CamSoper/Inferno/Hardware/Images/Telemetry.png

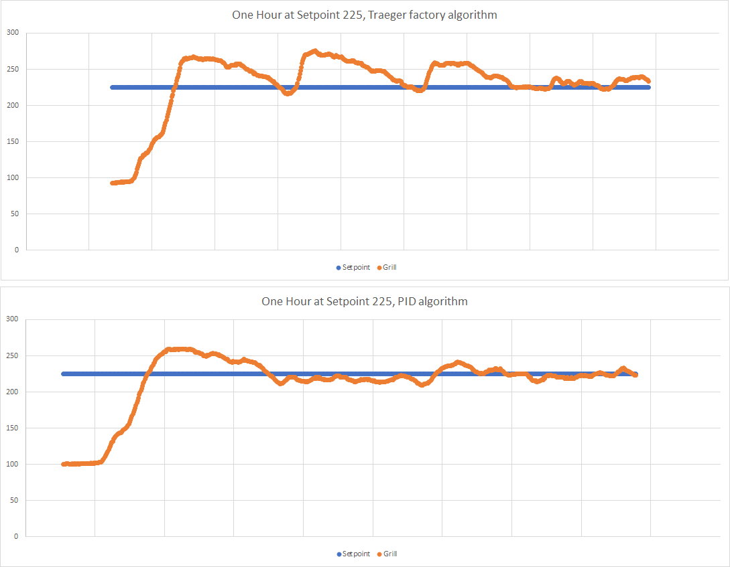
Hardware/Images/Telemetry.png
