CamSoper/Inferno/Hardware/Bezel/Bezel.stl

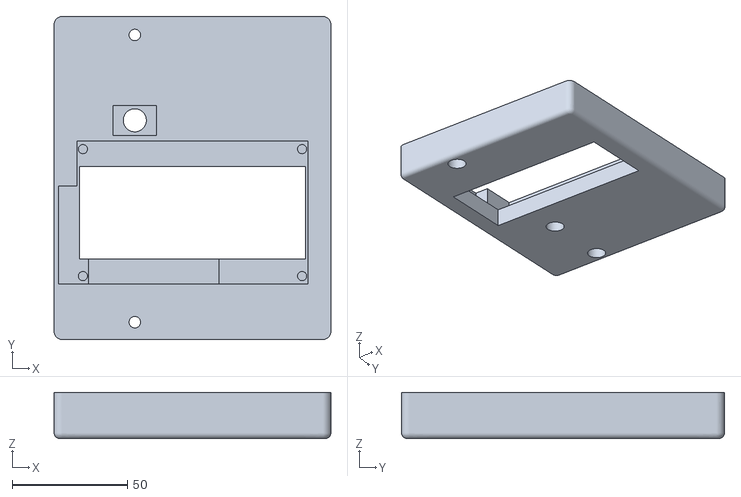
[picture p3: CAD file, 2019-07-02]
Hardware/Bezel/Bezel.stl
120.0 x 140.0 x 20.0
