CamSoper/Inferno/(list of files, drawings)

Other design files:
Hardware/Fritzing/Inferno.fzz
