CamSoper/Inferno/(threads)

Thread 9 (2025-03-19):

Shutdown doesn't cancel fire health alert

CamSoper, 2025-03-19:
Was running with the door open to test fire health alert, switched to shutdown and fire health alert never reset
