CamSoper/Inferno/(commit log)

2019-06-29 Moved igniter to its own thread
2019-06-30 More testing results
    [Inferno.fzz]
2019-06-30 updated fritzing diagram
    [Inferno.fzz]
2019-07-02 PID improvements
2019-07-02 Adding bezel design
    [Bezel.stl]
2019-07-12 Refactored relay-based devices
2019-07-12 A little more relay refactoring
2019-07-17 Updated image, AddSingleton
    [Inferno.fzz]
2022-11-24 Using built-in Clamp now
2022-12-07 Better fireminder, using built-in clamp()
2026-03-07 Reduce auger feed during reignition to prevent pellet accumulation
    When FireMinder detects the fire is out and activates the igniter for
    reignition, the Smoker now switches to a minimal feed pattern (3s on,
    57s off) instead of the normal cooking feed rate. This prevents
    unburned pellets from flooding the firepot, which could cause a
    dangerous temperature spike when they finally ignite.
    https://claude.ai/code/session_016pJd48GAzYXL4BTXptpHxs
2026-03-07 Reject out-of-range sensor readings to prevent HA graph spikes
    When an RTD sensor glitches (loose wire, SPI noise, etc.), the raw
    ADC value can produce wildly invalid temperatures (e.g., ADC=0
    yields Infinity via division by zero). These bad values get averaged
    into the 100-sample resistance buffer and flow straight through to
    MQTT/Home Assistant, causing massive graph spikes.
    Fix: validate each reading against a physically reasonable range
    (-20F to 1000F) before enqueuing. Bad readings are silently dropped,
    preserving the buffer of good values. If ALL readings are bad
    (sustained sensor failure), the queue empties and returns NaN, which
    Smoker.Temps already converts to -1 ("Unplugged" on di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
2026-03-07 Replace Newtonsoft.Json with System.Text.Json
    Newtonsoft.Json was only used in SmokerProxy for deserializing the
    status API response. Switch to System.Text.Json which is built into
    .NET and already used by ASP.NET on the API side. Uses
    PropertyNameCaseInsensitive to match ASP.NET's default camelCase
    output. Removes the Newtonsoft.Json package reference.
    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
2026-03-07 Add unit tests and GitHub Actions CI
    Create Inferno.Tests xUnit project with 32 tests covering:
    - RtdArray: ADC-to-resistance conversion, resistance-to-temp math,
    boundary values (ADC=0 → Infinity, ADC=1023)
    - Extensions: Clamp (double/int), IsCookingMode for all SmokerModes
    - SmokerPid: control variable direction (below/above setpoint),
    NaN guard, setpoint updates
    - FireMinder: GetFireCheckTemp for Smoke vs Hold modes, initial
    state, ResetFireStatus
    Add GitHub Actions workflow (ci.yml) that runs build + test on push
    to main and on PRs.
    Also make RtdArray's static math methods internal (were private) and
    add InternalsVisibleTo so the test project can access them.
    https://claude.ai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
2026-03-07 Add Pulumi C# project for SSH deployment to Raspberry Pi
    Replaces the Windows batch files with a cross-platform Pulumi
    deployment that:
    1. Publishes all three .NET projects locally (parallel)
    2. Stops running services on the Pi via SSH
    3. Copies published artifacts to the Pi via SCP
    4. Installs/starts systemd services and enables them on boot
    Uses Pulumi.Command provider for remote SSH commands and
    CopyToRemote for file transfer. Configurable via Pulumi config
    for host, user, remote path, and SSH key path.
    Usage:
    cd Inferno.Deploy
    pulumi up
    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
2026-03-07 Fix PID division by zero, shadowed CTS field, remove batch files, clean up TODOs
    - SmokerPid: change dT.Seconds (int, truncated) to dT.TotalSeconds
    (double). The old code divided by zero whenever the control loop
    ran faster than 1Hz, producing NaN/Infinity in the derivative term.
    - Smoker constructor: remove accidental type declaration that
    shadowed the _cts field with a local variable, leaving the field
    null until ModeLoop initialized it. A SetMode call during that
    window would NullRef.
    - Delete all publish.bat files (replaced by Pulumi deploy project).
    - Remove Visual Studio IDisposable template noise (commented-out
    finalizers, "TODO: free unmanaged resources", "Do not chang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
2026-03-24 Fix Fire Healthy state payload values and update device class in SmokerBridge
2026-04-28 Track Pulumi.main.yaml; rename ESC env to inferno-deploy/main
    Pulumi.<stack>.yaml was gitignored, but it's the only place the ESC env
    binding lives -- and Pulumi Cloud-side deployment settings have no env
    binding of their own. Without the file in version control, the deploy
    agent would either run with whatever local copy it happens to have or
    no binding at all. Tracking it now so the binding ships with commits.
    Env reference also flips inferno/mqtt -> inferno-deploy/main, aligning
    with the stack path (every <project>/main stack pairs with a
    <project>/main env).
2026-06-15 Staged fire recovery to stop starving recoverable fires
    The fire-health path collapsed the auger to ~5% duty (3s on / 57s off) the
    moment a fire looked unhealthy, which is below the rate that keeps a fire lit.
    A fire that had only dipped got starved out and became unrecoverable.
    Replace the binary healthy/starve behavior with floor-anchored staged recovery:
    - Fire-sustaining floor: no recovery path ever feeds below ~17% (the PID _uMin
    rationale). MaintenanceFeed (lid) and RecoveryFeed (~75%) both sit above it.
    - Lid-open detection (new LidMonitor): a catastrophic temp drop is cold air, not
    a dying fire. Ride it out on the maintenance floor with the PID frozen instead
    of triggering re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
2026-06-15 Restore unplugged-probe detection after sustained bad readings
    Rejecting out-of-range readings (to filter HA graph spikes) meant an unplugged
    probe's open-circuit readings were dropped and never enqueued. Since the queue
    only drains while enqueuing, it held its last good samples forever, so the probe
    kept reporting a stale temperature and never read as NaN/-1/"Unplugged".
    Track consecutive invalid readings per sensor; a brief burst is still filtered
    as noise, but a sustained run (~2s) drains the queue so the temperature reads
    NaN and surfaces as "Unplugged" again.
2026-06-15 Keep slow cold-start fires alive until ignition
    A fire warming from a cold start was killed by the fixed 10-minute igniter
    timeout before the grill could cross the 150F ignition threshold. The recovery
    path already resets its give-up clock on upward progress; apply the same logic
    to initial ignition so a slow-but-steady climb survives while a genuinely dead
    light (no temperature rise) still times out to Error.
2026-06-15 Harden cook stability: graceful shutdown, preheat race, PID guards (#20)
    Address the highest-value stability/safety findings from the project review:
    - Graceful shutdown (C1): Smoker is now IDisposable and the host's
    ApplicationStopping hook tears it down, so a clean stop/SIGTERM drives the
    auger and igniter to a safe off-state and releases GPIO/SPI/I2C instead of
    leaving relays in their last commanded state. All background loops (mode,
    fire minder, display, ADC read, preheat) now stop on a lifetime token.
    - Preheat sampling (C2/N1): moved PreheatMonitor.Update out of the Status
    property getter into a dedicated 1 Hz loop, and guarded the monitor's
    non-concurrent queue with a lo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
2026-06-15 Serialize Pulumi publish steps to avoid Inferno.Common build races (#21)
    The deploy created publish-api, publish-mqtt, and publish-cli with no
    dependency between them, so Pulumi ran the three `dotnet publish` commands in
    parallel. Every service references Inferno.Common, so the parallel publishes
    rebuilt Common concurrently and collided on its obj/bin outputs (MSBuild file
    locks), failing the deploy.
    Chain each publish command to the previous one via DependsOn so only one
    `dotnet publish` touches the shared Inferno.Common build outputs at a time.
    Ordering only; no functional change.
2026-06-20 Make Sear full-feed gate relative to ignition temp (#23)
    Sear now switches from the gentle establishing feed to full auger at a margin
    above where the fire caught (InitialIgnitionTemp + 25F, tunable) instead of an
    absolute 180F, so cold/windy starts no longer stall in the 150-180F band.
    FireMinder exposes InitialIgnitionTemp, anchored to the initial catch and
    unaffected by recovery relights.
    Claude-Session: https://claude.ai/code/session_01APzBbDz9nDWgpiCi1A48vw
2026-07-05 Harden safety paths: sensor fail-safe, monotonic time, structured logging (#24)
    * Harden safety paths: sensor fail-safe, monotonic time, structured logging
    Address several code-review findings, focused on the fire-control paths.
    Safety fixes:
    - Sear mode now turns the blower on before feeding the auger. Previously a
    Sear entered from a cold blower (e.g. straight after Ready with a warm
    firepot) could feed pellets with no combustion air.
    - FireMinder fails safe to Error on a sustained invalid grill reading during
    a cook, instead of interpreting the -1 "unplugged" sentinel as a dying fire
    and running the aggressive recovery feed blind.
    - Display disposes the LCD and driver before the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
2026-10-27 Re-seed the PID after lid-open and other Hold pauses (#25)
    Hold skips the PID while the lid is open, but the PID's last timestamp
    stayed put, so the first update after the lid closed computed dt over
    the whole lid-open gap (up to LidMonitor's 3-minute latch) and folded
    error * gap into the integral. With the grill still ~20F low that is
    roughly +0.33 duty on the next cycle: an overfeed right as the lid
    closes, the overshoot the old comment said couldn't happen.
    SmokerPid.Pause() marks the state for re-seeding, reusing the existing
    NaN re-seed path: the next update keeps the integral, re-seeds time and
    temperature, and integrates nothing. The seed pass now returns P plus
    the held integral in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
